MakerSpaceNewcastle/access-controller-fw/README.md

# RFID_access_controller

[Please see the Project Wiki for more details](https://github.com/davidmpye/RFID_access_controller/wiki)
