MakerSpaceNewcastle/access-controller-fw/Eagle/rfid_accessctl.brd

## EAGLE design Eagle/rfid_accessctl.brd (2016-06-22)

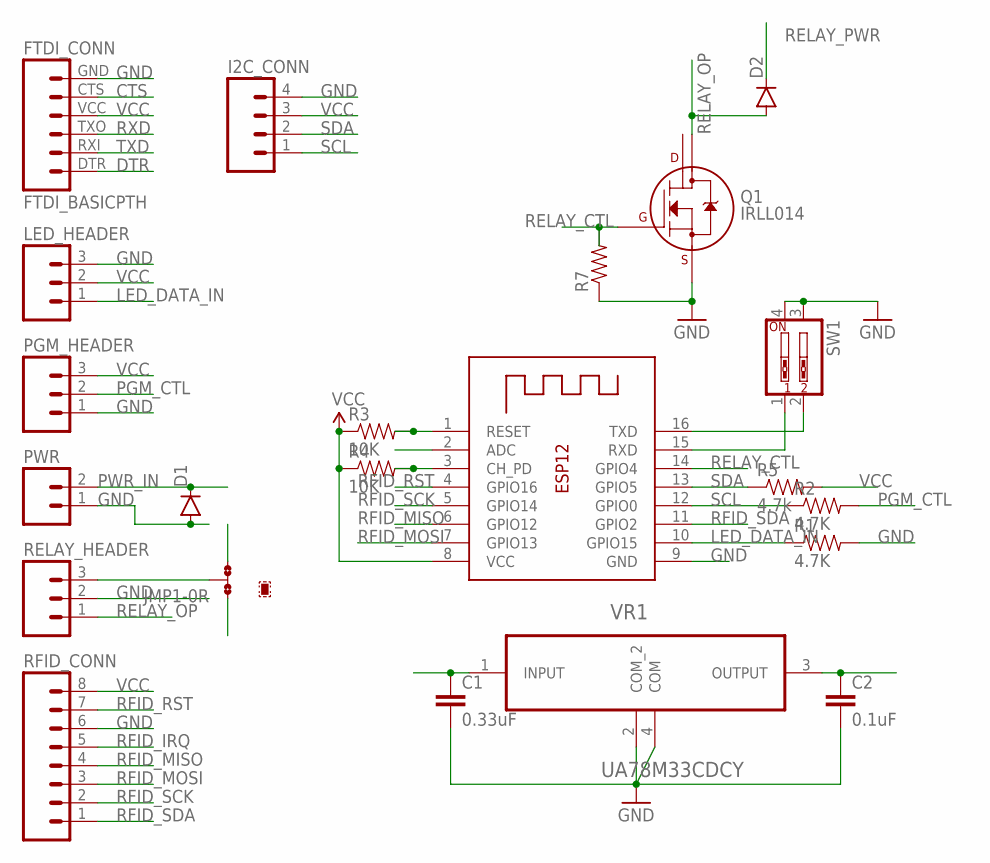
[picture p1: schematic rfid_accessctl.sch]

Parts:
C1: 0.33uF; 0805
C2: 0.1uF; 0805
D1, D2: DIODESMA; SMA-DIODE
FTDI_CONN: FTDI_BASICPTH; FTDI_BASIC
I2C_CONN: M04PTH; 1X04
JMP1: 0R-JUMPB; B0R-JMP
LED_HEADER: M03PTH; 1X03
PGM_HEADER: M03PTH; 1X03
PWR: M02PTH; 1X02
Q1: IRLL014; SOT-223
R1, R2: 4.7K; 0603-RES
R3, R4: 10K; 0603-RES
R5: 4.7k; 0603-RES
R7: RESISTOR0603-RES; 0603-RES
RELAY_HEADER: M03PTH; 1X03
RFID_CONN: M08; 1X08_ROUND
SW1: SW_DIP-2-SMT-HALFSIZE; DIPSWITCH-02-50MIL
VR1: UA78M33CDCY; SOT230P700X180-4N
X1: ESP-12

Connections:
CTS: FTDI_CONN.CTS (5)
DTR: FTDI_CONN.DTR (1)
GND: C1.2, C2.2, D1.A, FTDI_CONN.GND (6), I2C_CONN.4, LED_HEADER.3, PGM_HEADER.1, PWR.1, Q1.3 (S), R1.2, R7.1, RELAY_HEADER.2, RFID_CONN.6, SW1.3, SW1.4, VR1.2 (COM_2), VR1.4 (COM), X1.9 (GND)
LED_DATA_IN: LED_HEADER.1, R1.1, X1.10 (GPIO15)
unnamed: R3.2, X1.1 (RESET)
unnamed: R4.2, X1.3 (CH_PD)
PGM_CTL: PGM_HEADER.2, R2.2
PWR_IN: C1.1, D1.C, JMP1.3, PWR.2, VR1.1 (INPUT)
RELAY_CTL: Q1.1 (G), R7.2, X1.14 (GPIO4)
RELAY_OP: D2.A, Q1.2 (D1), RELAY_HEADER.1
RELAY_PWR: D2.C, JMP1.2, RELAY_HEADER.3
RFID_IRQ: RFID_CONN.5
RFID_MISO: RFID_CONN.4, X1.6 (GPIO12)
RFID_MOSI: RFID_CONN.3, X1.7 (GPIO13)
RFID_RST: RFID_CONN.7, X1.4 (GPIO16)
RFID_SCK: RFID_CONN.2, X1.5 (GPIO14)
RFID_SDA: RFID_CONN.1, X1.11 (GPIO2)
RXD: FTDI_CONN.TXO (3), SW1.1, X1.15 (RXD)
SCL: I2C_CONN.1, R2.1, X1.12 (GPIO0)
SDA: I2C_CONN.2, R5.1, X1.13 (GPIO5)
TXD: FTDI_CONN.RXI (2), SW1.2, X1.16 (TXD)
VCC: C2.1, FTDI_CONN.VCC (4), I2C_CONN.3, JMP1.1, LED_HEADER.2, PGM_HEADER.3, R3.1, R4.1, R5.2, RFID_CONN.8, VR1.3 (OUTPUT), X1.8 (VCC)

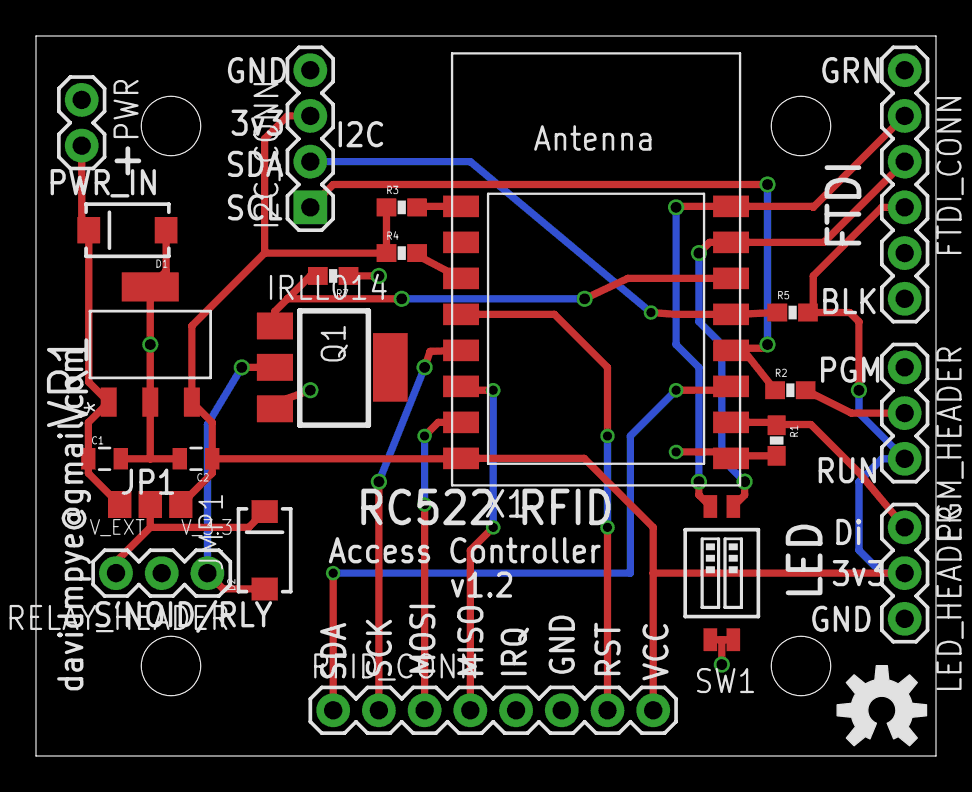
[picture p2: board rfid_accessctl.brd from above]

Board: 2 copper layers, 50.0 x 40.0 mm, 27 parts (0 on the bottom side), 19 nets.

Other parts of the board:
U$2, U$3, U$4, U$5: STAND-OFF
U$6: OSHW-LOGO-M
