MakerSpaceNewcastle/access-controller-fw/(commit log)

2015-12-24 Initial Import
    [rfid_accessctl.brd, rfid_accessctl.sch]
2015-12-24 moved to eagle subdir
    [rfid_accessctl.brd, rfid_accessctl.sch]
2015-12-28 Move screw holes to avoid screws fouling.
    [rfid_accessctl.brd]
2016-01-24 update to v1.1, with fix for I2C/GPIO15
2016-06-21 Start v1.2 board version
    [rfid_accessctl.brd, rfid_accessctl.sch]
2016-06-21 Updates for 0603
    [rfid_accessctl.brd, rfid_accessctl.sch]
2016-06-21 Add DIP switches on serial lines (optional)
    [rfid_accessctl.brd, rfid_accessctl.sch]
2016-06-22 Final updates, as per mfr
    [rfid_accessctl.brd, rfid_accessctl.sch]
2016-08-01 Add in i2c pin definitions
2016-08-30 More structural realigntment, blue led for resting if on wifi, magenta if offline
2016-09-14 Oops, fix #define for MQTT SUPPORT
    [main.cpp]
2016-10-12 First import of laser cut acrylic 3mm case example
    [examplecase.scad]
2016-10-20 Much redesigning with OTA update support etc.
    [commshandler.cpp, commshandler.h, main.cpp]
2016-10-23 Minor change - fix #define, and add small delay for MQTT to connect
    [commshandler.cpp]
2016-10-26 Add cable entry slot
    [examplecase.scad]
2016-10-26 Fix issue with LED not being reset on latching controllers
    [main.cpp]
2016-11-09 Fix URL logging bug (& > ?)
    [commshandler.cpp]
2016-11-09 Add $fn to round holes
    [examplecase.scad]
2016-11-16 Don't log deactivation/mqtt if it's a non-latching device.
2017-08-10 Added #defines to set LED colours - mainly for stealth mode ;-)
2017-08-24 Add in a reboot 'hack' if the free heap drops <5k. No evidence of a leak that would cause this but a few random hangs have occurred...
    [main.cpp]
2019-12-05 Add sample
2022-10-05 Update subtle cardreading bug
    [main.cpp]
2022-10-05 Update to LittleFS and squash stack-overload bug
    [commshandler.cpp, commshandler.h, main.cpp]
2025-04-26 Add attempted fix to:
    Reset mfrc522 every 255 read cycles
    Set reset pin to UINT8_MAX to indicate unused
    [main.cpp]
